citrusrook/Planetary-Gear-Gen/reference/micro-gear_ring_22.stl

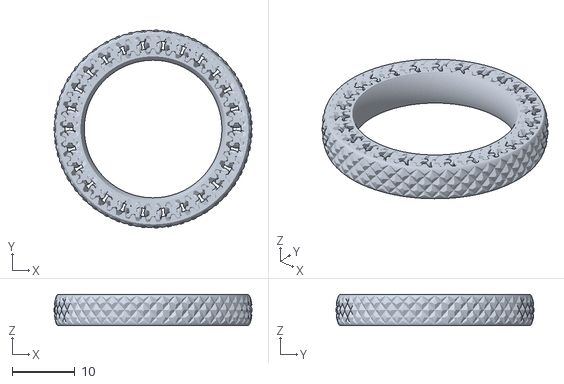
[picture p1: CAD file, 2026-10-08]
reference/micro-gear_ring_22.stl
31.7 x 31.7 x 5.00
