citrusrook/Planetary-Gear-Gen/(commit log)

2026-10-08 Parametric herringbone planetary bearing: core math, FreeCAD object, tests, handoff
    Claude-Session: https://claude.ai/code/session_01Jgh92aHAWPV46xRKjRRvkT
    [micro-gear_ring_22.stl]
2026-10-08 Web app: browser port of the generator with live solver, 3D preview and STL export
    - web/js/pbmath.js: port of core/pb_math.py; matches fixtures exactly
    (profiles, phasing, twist, report lines, all solver cases incl. notes)
    - web/js/meshgen.js: direct watertight mesh (twisted extrusions, per-loop
    z sections, tooth-aware chamfers, earcut caps with T-junction repair)
    - web/js/app.js + view3d.js: FreeCAD-style parameter groups, lock semantics,
    report, mesh checks, three.js preview (animate / section), STL export
    - web/tests.html: 66 browser checks against fixtures and mesh invariants
    - tests/test_stl_export.py: trimesh checks on exported STLs (bodies,
    watertight, volumes vs FreeCAD, zer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
